PR-Solution-EU/FS20Uno/README.md

# FS20Uno
Arduino Uno controller for electric rooflight window and shutter using pushbuttons and FS20-SM8 receiver.

Detailed description under Wiki https://github.com/curzon01/FS20Uno/wiki.
