PR-Solution-EU/FS20Uno/Schaltplan/FS20SM8_DFF_MPC23017.pdf

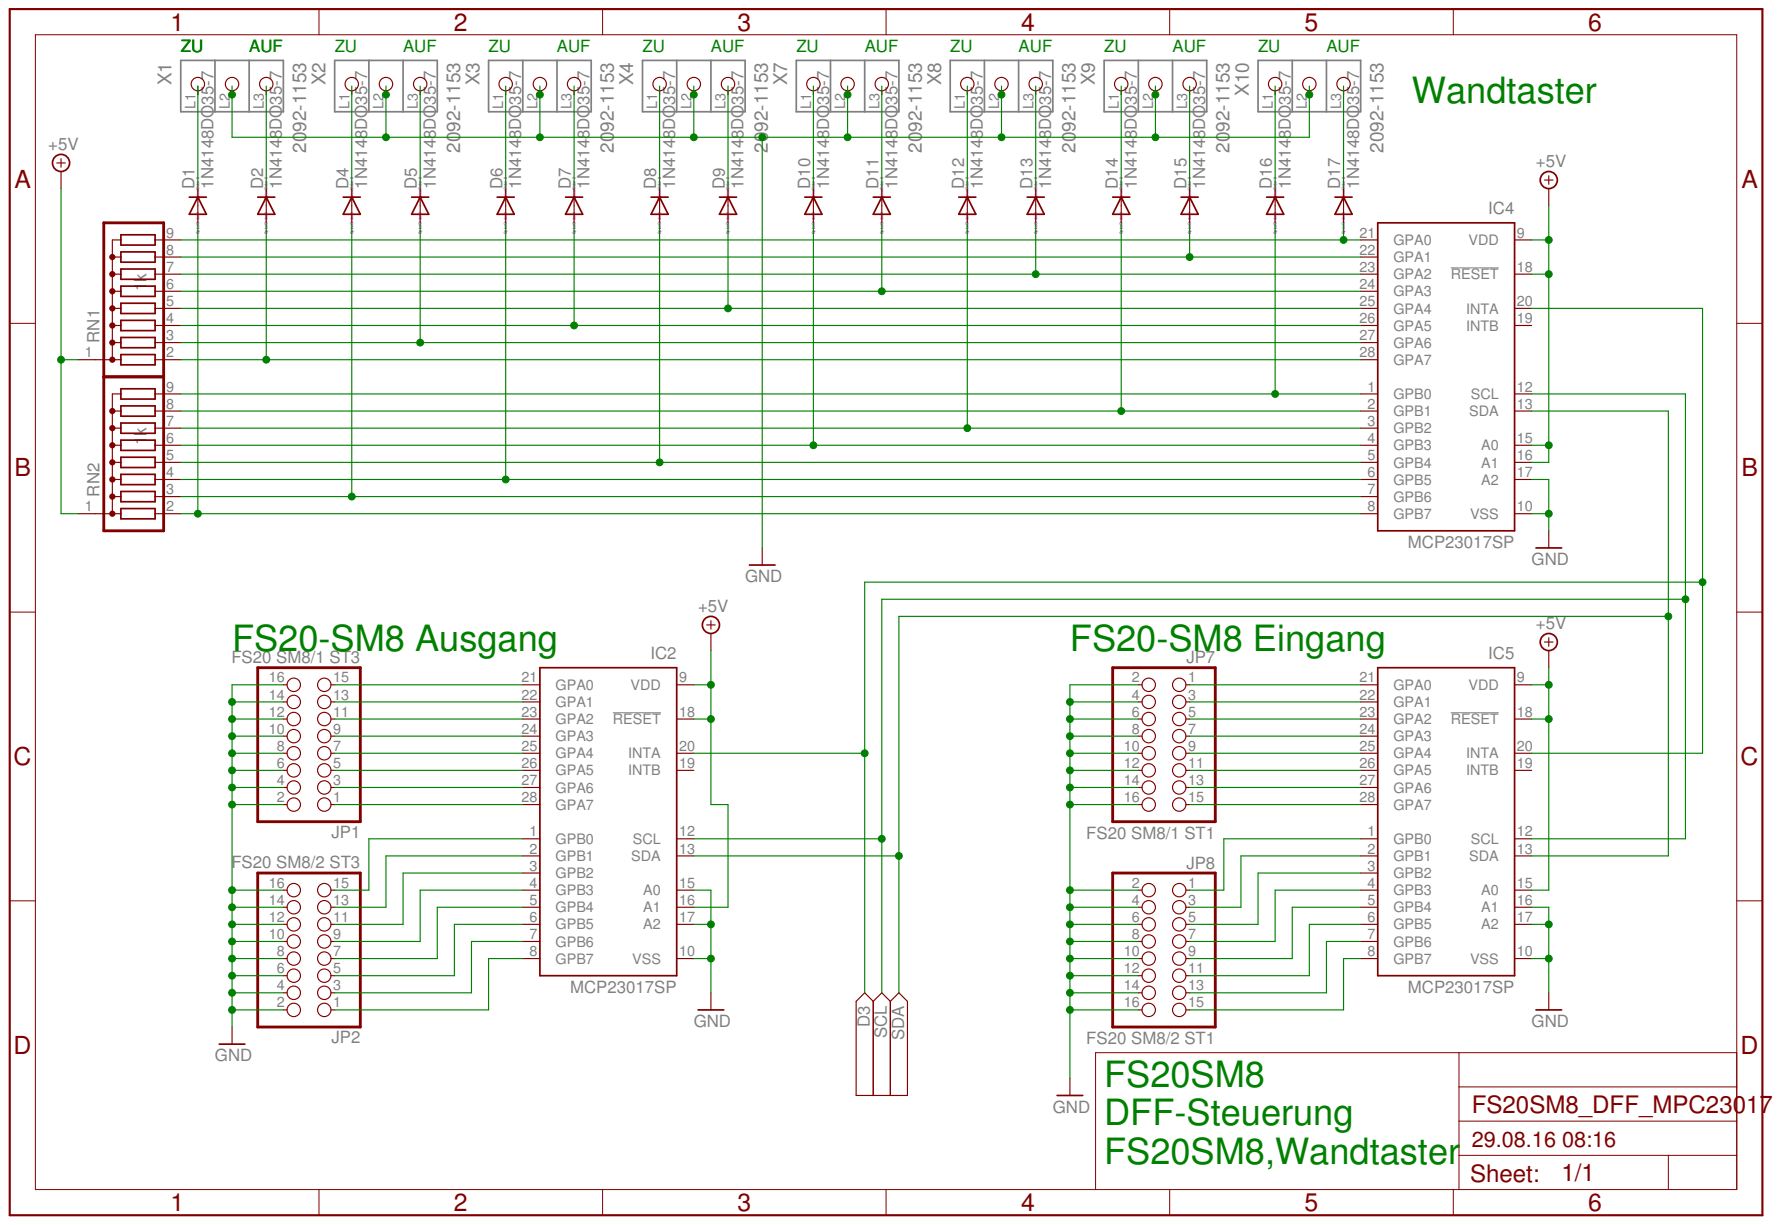
[picture p1: page 1]

FS20SM8 DFF-Steuerung FS20SM8,Wandtaster

Sheet: 1/1

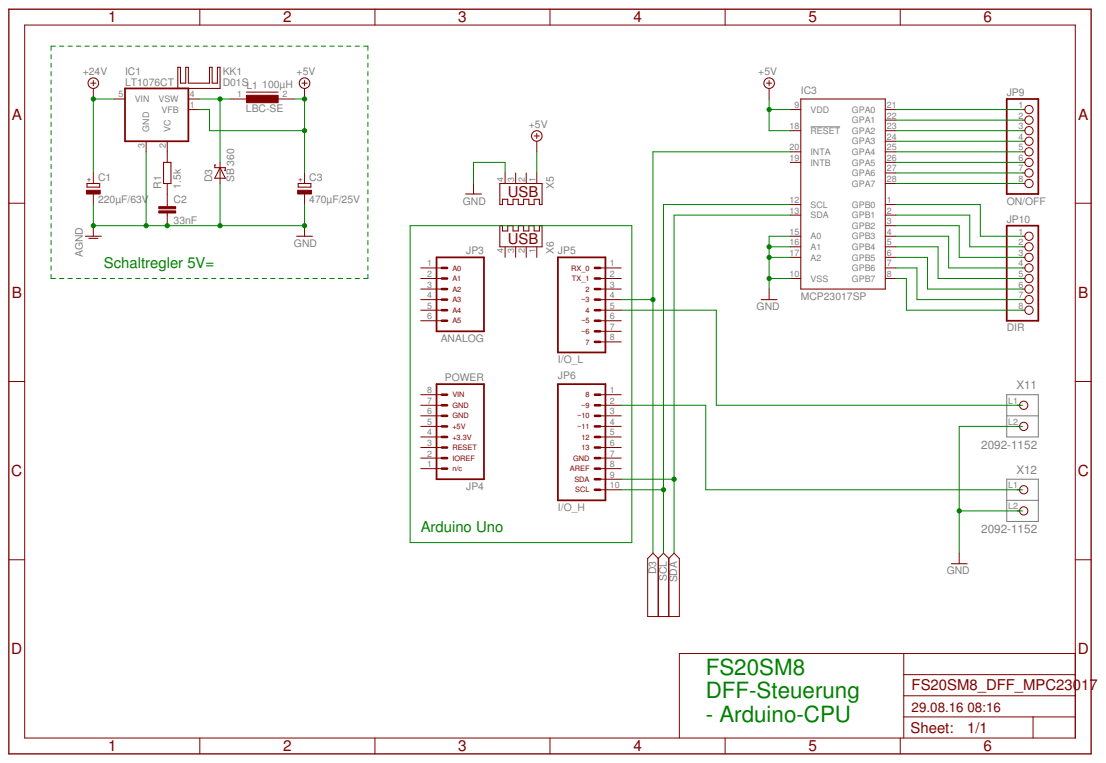
[picture p2: page 2]

FS20SM8 DFF-Steuerung - Arduino-CPU

Sheet: 1/1
