PR-Solution-EU/FS20Uno/Schaltplan/FS20SM8_DFF_Relais.pdf

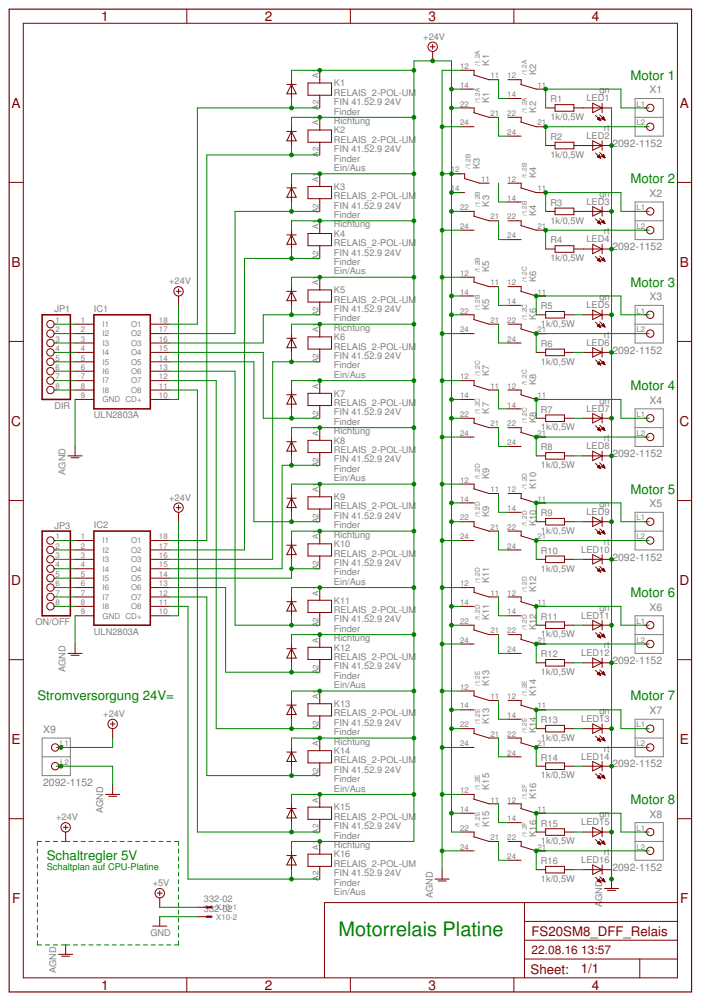
[picture p3: page 1]
