PR-Solution-EU/FS20Uno/Schaltplan/FS20SM8_DFF_MPC23017.sch

## EAGLE design Schaltplan/FS20SM8_DFF_MPC23017.sch (2016-08-29)

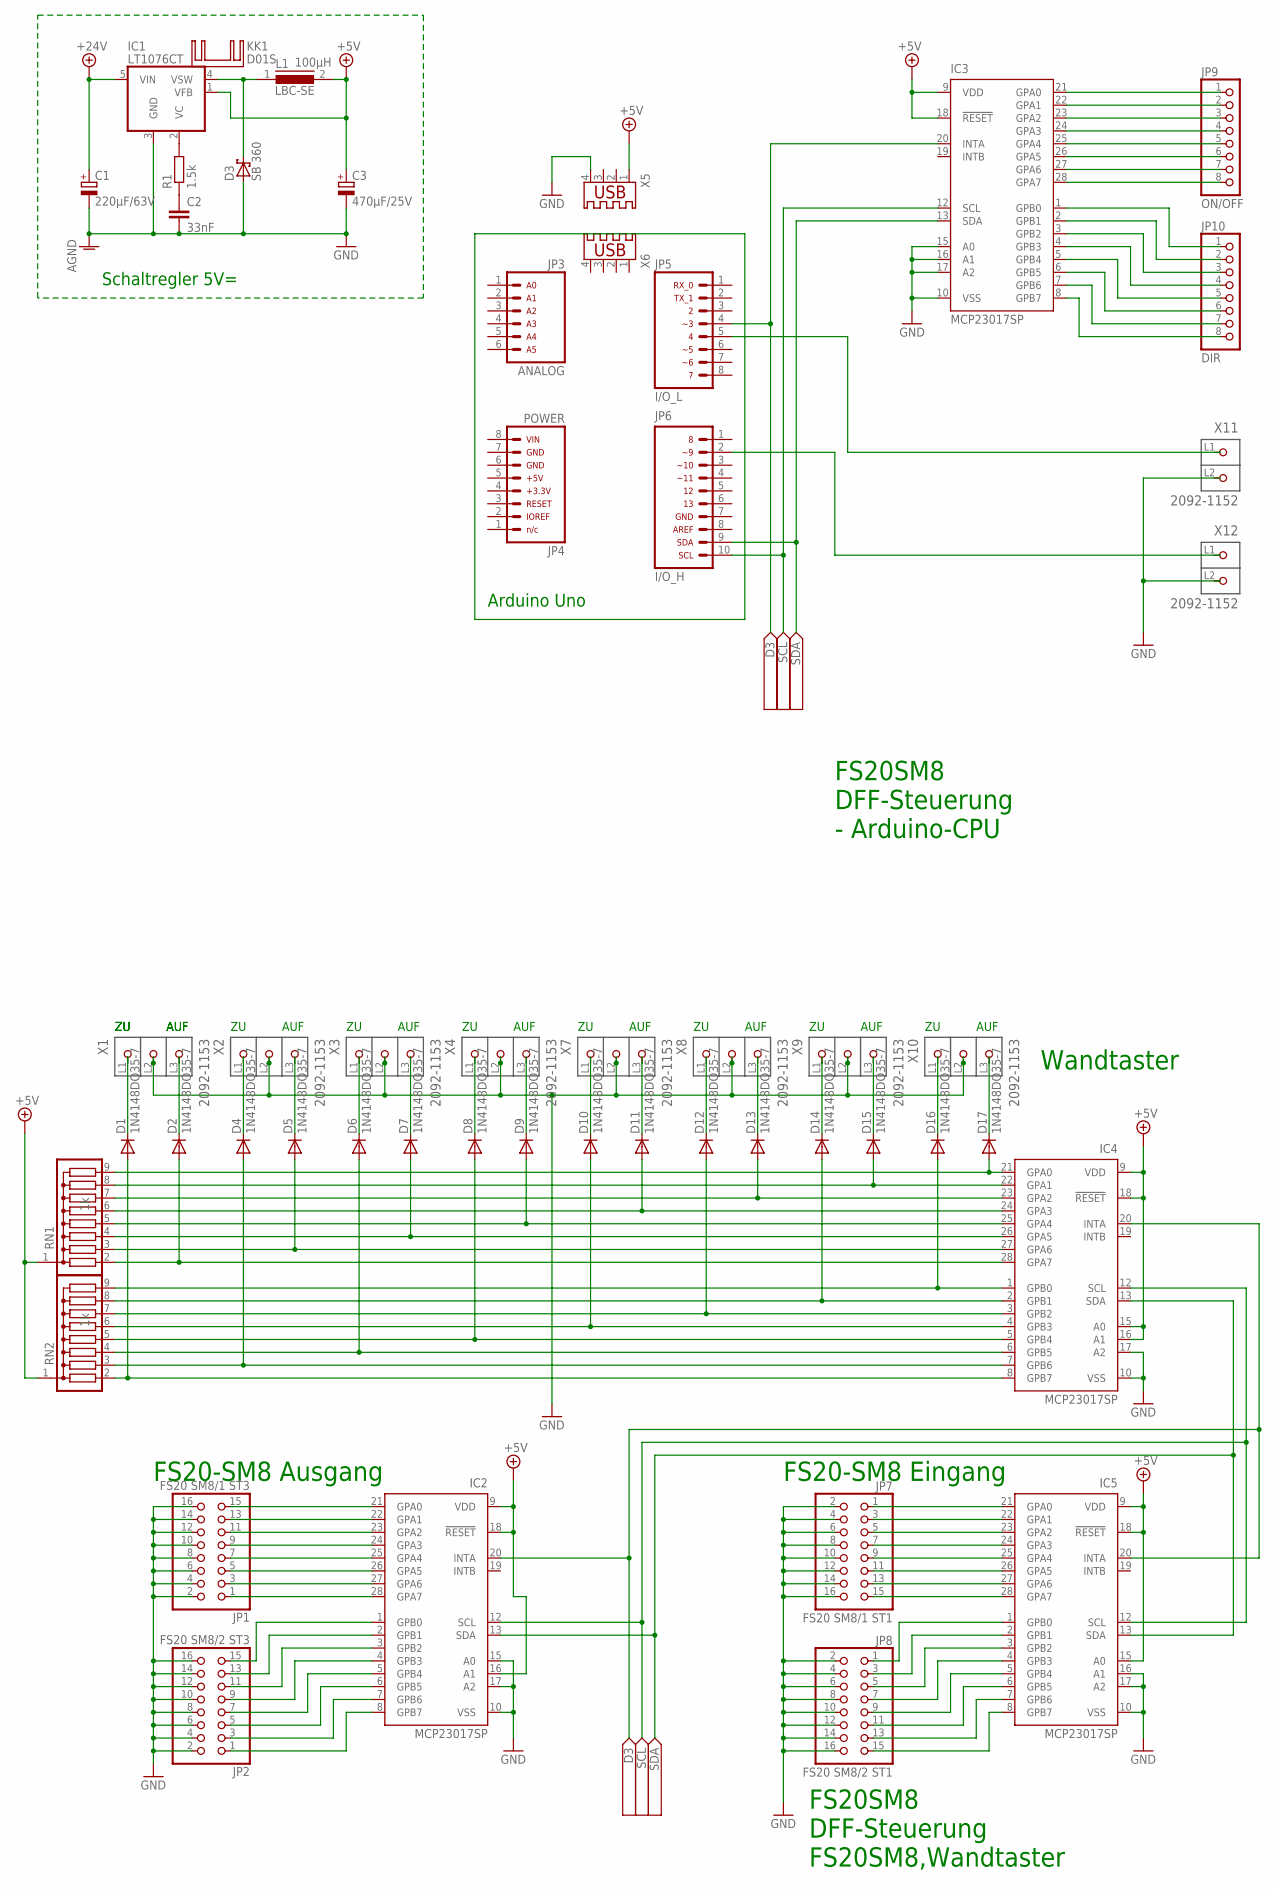
[picture p4: schematic FS20SM8_DFF_MPC23017.sch]

Parts:
C1: 220µF/63V; E5-10,5
C2: 33nF; C050-035X075
C3: 470µF/25V; E5-10,5
D1, D2, D4, D5, D6, D7, D8, D9, D10, D11, D12, D13, D14, D15, D16, D17: 1N4148DO35-7; DO35-7
D3: SB 360; DO201T15
IC1: LT1076CT; TO220-5
IC2, IC3, IC4, IC5: MCP23017SP; DIL28-3
JP1: FS20 SM8/1 ST3; 2X08
JP2: FS20 SM8/2 ST3; 2X08
JP3: ARDUINO_CONN-ANALOGSIP; CONN-1X06
JP4: ARDUINO_CONN-POWERSIP; CONN-1X08
JP5: ARDUINO_CONN-IO_LSIP; CONN-1X08
JP6: ARDUINO_CONN-IO_HSIP; CONN-1X10
JP7: FS20 SM8/1 ST1; 2X08
JP8: FS20 SM8/2 ST1; 2X08
JP9: ON/OFF; 1X08
JP10: DIR; 1X08
KK1: D01S
L1: LBC-SE
R1: 1.5k; 0204V
RN1, RN2: G08R; SIL9
X1, X2, X3, X4, X7, X8, X9, X10: 2092-1153; P-2092-1153
X5, X6: USB-A003
X11, X12: 2092-1152; P-2092-1152

Connections:
+5V: C3.+, IC1.1 (VFB), IC2.9 (VDD), IC2.16 (A1), IC2.18 (!RESET), IC3.9 (VDD), IC3.18 (!RESET), IC4.9 (VDD), IC4.15 (A0), IC4.16 (A1), IC4.18 (!RESET), IC5.9 (VDD), IC5.15 (A0), IC5.18 (!RESET), L1.2, RN1.1, RN2.1, X5.1
+24V: C1.+, IC1.5 (VIN)
AGND: C1.-, C2.2, C3.-, D3.A, IC1.3 (GND)
GND: IC2.10 (VSS), IC2.15 (A0), IC2.17 (A2), IC3.10 (VSS), IC3.15 (A0), IC3.16 (A1), IC3.17 (A2), IC4.10 (VSS), IC4.17 (A2), IC5.10 (VSS), IC5.16 (A1), IC5.17 (A2), JP1.2, JP1.4, JP1.6, JP1.8, JP1.10, JP1.12, JP1.14, JP1.16, JP2.2, JP2.4, JP2.6, JP2.8, JP2.10, JP2.12, JP2.14, JP2.16, JP7.2, JP7.4, JP7.6, JP7.8, JP7.10, JP7.12, JP7.14, JP7.16, JP8.2, JP8.4, JP8.6, JP8.8, JP8.10, JP8.12, JP8.14, JP8.16, X1.L2 (P2), X2.L2 (P2), X3.L2 (P2), X4.L2 (P2), X5.4, X7.L2 (P2), X8.L2 (P2), X9.L2 (P2), X10.L2 (P2)
unnamed: IC3.20 (INTA), JP5.4
unnamed: IC3.12 (SCL), JP6.10
unnamed: IC3.13 (SDA), JP6.9
unnamed: IC3.1 (GPB0), JP10.1
unnamed: IC3.2 (GPB1), JP10.2
unnamed: IC3.3 (GPB2), JP10.3
unnamed: IC3.4 (GPB3), JP10.4
unnamed: IC1.2 (VC), R1.2
unnamed: IC3.5 (GPB4), JP10.5
unnamed: IC3.6 (GPB5), JP10.6
unnamed: IC2.21 (GPA0), JP1.15
unnamed: IC3.7 (GPB6), JP10.7
unnamed: D1.C, X1.L1 (P1)
unnamed: D2.C, X1.L3 (P3)
unnamed: D5.C, X2.L3 (P3)
unnamed: D4.C, X2.L1 (P1)
unnamed: D7.C, X3.L3 (P3)
unnamed: D6.C, X3.L1 (P1)
unnamed: D8.C, X4.L1 (P1)
unnamed: IC3.21 (GPA0), JP9.1
unnamed: IC3.22 (GPA1), JP9.2
unnamed: IC3.23 (GPA2), JP9.3
unnamed: IC3.24 (GPA3), JP9.4
unnamed: D9.C, X4.L3 (P3)
unnamed: D10.C, X7.L1 (P1)
unnamed: D11.C, X7.L3 (P3)
unnamed: D12.C, X8.L1 (P1)
unnamed: IC3.25 (GPA4), JP9.5
unnamed: IC3.26 (GPA5), JP9.6
unnamed: IC3.27 (GPA6), JP9.7
unnamed: IC3.28 (GPA7), JP9.8
unnamed: D13.C, X8.L3 (P3)
unnamed: C2.1, R1.1
unnamed: D14.C, X9.L1 (P1)
unnamed: D15.C, X9.L3 (P3)
unnamed: D16.C, X10.L1 (P1)
unnamed: D17.C, X10.L3 (P3)
unnamed: IC3.8 (GPB7), JP10.8
unnamed: IC5.1 (GPB0), JP8.1
unnamed: IC5.2 (GPB1), JP8.3
unnamed: IC5.3 (GPB2), JP8.5
unnamed: IC2.22 (GPA1), JP1.13
unnamed: IC2.23 (GPA2), JP1.11
unnamed: D3.C, IC1.4 (VSW), L1.1
unnamed: IC2.24 (GPA3), JP1.9
unnamed: IC2.25 (GPA4), JP1.7
unnamed: IC2.26 (GPA5), JP1.5
unnamed: IC2.27 (GPA6), JP1.3
unnamed: IC2.28 (GPA7), JP1.1
unnamed: IC5.21 (GPA0), JP7.1
unnamed: IC5.22 (GPA1), JP7.3
unnamed: IC5.23 (GPA2), JP7.5
unnamed: IC5.24 (GPA3), JP7.7
unnamed: IC5.25 (GPA4), JP7.9
unnamed: IC5.26 (GPA5), JP7.11
unnamed: IC5.27 (GPA6), JP7.13
unnamed: IC5.28 (GPA7), JP7.15
unnamed: IC5.4 (GPB3), JP8.7
unnamed: IC5.5 (GPB4), JP8.9
unnamed: IC5.6 (GPB5), JP8.11
unnamed: IC5.7 (GPB6), JP8.13
unnamed: IC5.8 (GPB7), JP8.15
unnamed: IC2.12 (SCL), IC4.12 (SCL), IC5.12 (SCL)
unnamed: IC2.13 (SDA), IC4.13 (SDA), IC5.13 (SDA)
unnamed: IC2.20 (INTA), IC4.20 (INTA), IC5.20 (INTA)
unnamed: D17.A, IC4.21 (GPA0), RN1.9
unnamed: D16.A, IC4.1 (GPB0), RN2.9
unnamed: D14.A, IC4.2 (GPB1), RN2.8
unnamed: D13.A, IC4.23 (GPA2), RN1.7
unnamed: D12.A, IC4.3 (GPB2), RN2.7
unnamed: D11.A, IC4.24 (GPA3), RN1.6
unnamed: D10.A, IC4.4 (GPB3), RN2.6
unnamed: D15.A, IC4.22 (GPA1), RN1.8
unnamed: D9.A, IC4.25 (GPA4), RN1.5
unnamed: D8.A, IC4.5 (GPB4), RN2.5
unnamed: D7.A, IC4.26 (GPA5), RN1.4
unnamed: D6.A, IC4.6 (GPB5), RN2.4
unnamed: D5.A, IC4.27 (GPA6), RN1.3
unnamed: D4.A, IC4.7 (GPB6), RN2.3
unnamed: D2.A, IC4.28 (GPA7), RN1.2
unnamed: D1.A, IC4.8 (GPB7), RN2.2
unnamed: IC2.1 (GPB0), JP2.15
unnamed: IC2.2 (GPB1), JP2.13
unnamed: IC2.3 (GPB2), JP2.11
unnamed: IC2.4 (GPB3), JP2.9
unnamed: IC2.5 (GPB4), JP2.7
unnamed: IC2.6 (GPB5), JP2.5
unnamed: IC2.7 (GPB6), JP2.3
unnamed: IC2.8 (GPB7), JP2.1

Notes on the sheet:
FS20SM8 DFF-Steuerung - Arduino-CPU
FS20SM8 DFF-Steuerung FS20SM8,Wandtaster
AUF
Wandtaster
FS20-SM8 Ausgang
FS20-SM8 Eingang
Arduino Uno
Schaltregler 5V=
