PR-Solution-EU/FS20Uno/Schaltplan/FS20SM8_DFF_Relais.sch

## EAGLE design Schaltplan/FS20SM8_DFF_Relais.sch (2016-08-22)

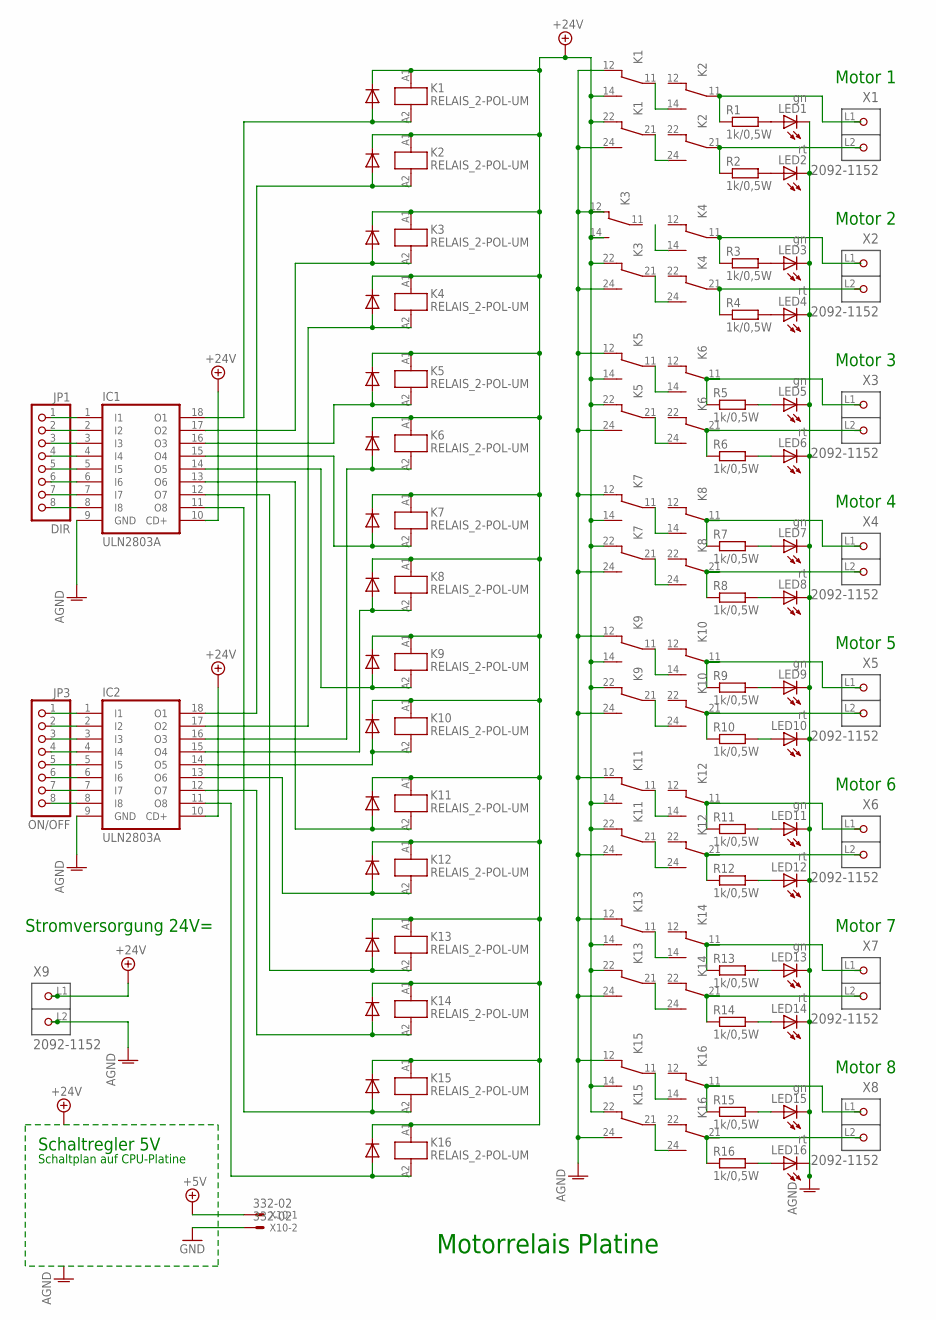
[picture p5: schematic FS20SM8_DFF_Relais.sch]

Parts:
IC1, IC2: ULN2803A; DIL18
JP1: DIR; 1X08
JP3: ON/OFF; 1X08
K1, K2, K3, K4, K5, K6, K7, K8, K9, K10, K11, K12, K13, K14, K15, K16: RELAIS_2-POL-UM
LED1, LED3, LED5, LED7, LED9, LED11, LED13, LED15: gn; LED3MM
LED2, LED4, LED6, LED8, LED10, LED12, LED14, LED16: rt; LED3MM
R1, R2, R3, R4, R5, R6, R7, R8, R9, R10, R11, R12, R13, R14, R15, R16: 1k/0,5W; 0207/2V
X1, X2, X3, X4, X5, X6, X7, X8, X9: 2092-1152; P-2092-1152
X10: 332-02

Connections:
+5V: X10.1
+24V: IC1.10 (CD+), IC2.10 (CD+), K1.14 (4), K1.22 (2), K1.A1, K2.A1, K3.12 (2), K3.14 (4), K3.22 (2), K3.A1, K4.A1, K5.14 (4), K5.22 (2), K5.A1, K6.A1, K7.14 (4), K7.22 (2), K7.A1, K8.A1, K9.14 (4), K9.22 (2), K9.A1, K10.A1, K11.14 (4), K11.22 (2), K11.A1, K12.A1, K13.14 (4), K13.22 (2), K13.A1, K14.A1, K15.14 (4), K15.22 (2), K15.A1, X9.L1 (P1)
AGND: IC1.9 (GND), IC2.9 (GND), K1.12 (2), K1.24 (4), K3.24 (4), K5.12 (2), K5.24 (4), K7.12 (2), K7.24 (4), K9.12 (2), K9.24 (4), K11.12 (2), K11.24 (4), K13.12 (2), K13.24 (4), K15.12 (2), K15.24 (4), LED1.K (C), LED2.K (C), LED3.K (C), LED4.K (C), LED5.K (C), LED6.K (C), LED7.K (C), LED8.K (C), LED9.K (C), LED10.K (C), LED11.K (C), LED12.K (C), LED13.K (C), LED14.K (C), LED15.K (C), LED16.K (C), X9.L2 (P2)
GND: X10.2
unnamed: K1.11 (1), K2.14 (4)
unnamed: IC2.18 (O1), K2.A2
unnamed: IC1.18 (O1), K1.A2
unnamed: K1.21 (1), K2.24 (4)
unnamed: IC1.17 (O2), K3.A2
unnamed: IC2.17 (O2), K4.A2
unnamed: IC1.16 (O3), K5.A2
unnamed: IC2.16 (O3), K6.A2
unnamed: IC1.15 (O4), K7.A2
unnamed: IC2.15 (O4), K8.A2
unnamed: K4.11 (1), R3.1
unnamed: K2.11 (1), R1.1
unnamed: K2.21 (1), R2.1
unnamed: K4.21 (1), R4.1
unnamed: K3.21 (1), K4.24 (4)
unnamed: K6.11 (1), R5.1
unnamed: K6.21 (1), R6.1
unnamed: K5.11 (1), K6.14 (4)
unnamed: K5.21 (1), K6.24 (4)
unnamed: K8.11 (1), R7.1
unnamed: K8.21 (1), R8.1
unnamed: K7.11 (1), K8.14 (4)
unnamed: K7.21 (1), K8.24 (4)
unnamed: IC1.14 (O5), K9.A2
unnamed: IC2.14 (O5), K10.A2
unnamed: IC1.13 (O6), K11.A2
unnamed: IC2.13 (O6), K12.A2
unnamed: IC1.12 (O7), K13.A2
unnamed: IC2.12 (O7), K14.A2
unnamed: IC1.11 (O8), K15.A2
unnamed: IC2.11 (O8), K16.A2
unnamed: K10.11 (1), R9.1
unnamed: K10.21 (1), R10.1
unnamed: K9.11 (1), K10.14 (4)
unnamed: K9.21 (1), K10.24 (4)
unnamed: K12.11 (1), R11.1
unnamed: K12.21 (1), R12.1
unnamed: K11.11 (1), K12.14 (4)
unnamed: K11.21 (1), K12.24 (4)
unnamed: K14.11 (1), R13.1
unnamed: K14.21 (1), R14.1
unnamed: K13.11 (1), K14.14 (4)
unnamed: K13.21 (1), K14.24 (4)
unnamed: K16.11 (1), R15.1
unnamed: K16.21 (1), R16.1
unnamed: K15.11 (1), K16.14 (4)
unnamed: K15.21 (1), K16.24 (4)
unnamed: LED1.A, R1.2
unnamed: LED2.A, R2.2
unnamed: LED3.A, R3.2
unnamed: LED4.A, R4.2
unnamed: LED5.A, R5.2
unnamed: LED6.A, R6.2
unnamed: LED7.A, R7.2
unnamed: LED8.A, R8.2
unnamed: LED9.A, R9.2
unnamed: LED10.A, R10.2
unnamed: LED11.A, R11.2
unnamed: LED12.A, R12.2
unnamed: LED13.A, R13.2
unnamed: LED14.A, R14.2
unnamed: LED15.A, R15.2
unnamed: LED16.A, R16.2
unnamed: IC1.1 (I1), JP1.1
unnamed: IC1.2 (I2), JP1.2
unnamed: IC1.3 (I3), JP1.3
unnamed: IC1.4 (I4), JP1.4
unnamed: IC1.5 (I5), JP1.5
unnamed: IC1.6 (I6), JP1.6
unnamed: IC1.7 (I7), JP1.7
unnamed: IC1.8 (I8), JP1.8
unnamed: IC2.1 (I1), JP3.1
unnamed: IC2.2 (I2), JP3.2
unnamed: IC2.3 (I3), JP3.3
unnamed: IC2.4 (I4), JP3.4
unnamed: IC2.5 (I5), JP3.5
unnamed: IC2.6 (I6), JP3.6
unnamed: IC2.7 (I7), JP3.7
unnamed: IC2.8 (I8), JP3.8

Notes on the sheet:
Motor 1
Motor 2
Motor 3
Motor 4
Motor 5
Motor 6
Motor 7
Motor 8
Motorrelais Platine
Stromversorgung 24V=
Schaltregler 5V
Schaltplan auf CPU-Platine
