PR-Solution-EU/FS20Uno/FS20Uno.h

#define MPC1    			0x0		// MCP23017 #1 I2C Address
#define MPC2    			0x1		// MCP23017 #2 I2C Address
#define MPC3				0x2		// MCP23017 #3 I2C Address
#define MPC4    			0x3		// MCP23017 #4 I2C Address
#define MPC_MOTORRELAIS		MPC1	// MPC for motor relais
#define MPC_SM8BUTTON		MPC2	// MPC for FS20-SM8 key outputs
#define MPC_SM8STATUS		MPC3	// MPC for FS20-SM8 output
#define MPC_PUSHBUTTON		MPC4	// MPC for push buttons
#define MPC_INT_INPUT 		3		// Arduino port for MPC IRQ
#define STATUS_LED 			LED_BUILTIN	// LED
#define RAIN_INPUT 			4		// Arduino port for rain sensor
#define RAIN_INPUT_ACTIVE	0		// Active level
#define RAIN_ENABLE			9		// Arduino Port for rain enable/disable input
#define RAIN_ENABLE_ACTIVE	1		// Active level
#define RANDOM_SEED_ANALOG_READ1	0
#define RANDOM_SEED_ANALOG_READ2	1
#define RANDOM_SEED_ANALOG_READ3	2
#define DEFAULT_MOTORTYPE			0b01010101	// WIN/JAL/WIN/JAL...
#define DEFAULT_SENDSTATUS			false
#define DEFAULT_ECHO				false
#define DEFAULT_TERM				'\r'
#define DEFAULT_LOGIN_TIMEOUT		60	// sec
#define DEFAULT_PASSWORD			PSTR("31415")
#define DEFAULT_RAINRESUMETIME		300	// sec
#define DEFAULT_LED_NORMAL			0x20080200	// bit pattern
#define DEFAULT_LED_RAIN			0xd7f5fd7f	// bit pattern
#define DEFAULT_LED_BITCOUNT		30	// #
#define DEFAULT_LED_BITLENGTH		100	// ms
#define MAX_LEDPATTERN_BITS			32
#define SERIAL_BAUDRATE				115200
#define TIMER_MS					10
#define WATCHDOG_TIME				4000
#define WATCHDOG_REBOOT_DELAY		250
#define ALIVE_TIMER					500
#define RAIN_DEBOUNCE_TIME			20	// ms
#define WPB_DEBOUNCE_TIME			80	// ms
#define SM8_DEBOUNCE_TIME			20	// ms
#define MAX_MOTORS					8
#define RELAIS_OPERATE_TIME			20	// ms
#define MOTOR_SWITCHOVER			250	// ms
#define MOTOR_MINRUNTIME		 	500	// 0.5 seconds
#define MOTOR_MAXRUNTIME		 	600000	// 10 minutes
#define MOTOR_WINDOW_MAXRUNTIME		60000	// 60 seconds
#define MOTOR_JALOUSIE_MAXRUNTIME	20000	// 2 seconds
#define MOTOR_WINDOW_OVERTRAVELTIME		2000	// 2 seconds
#define MOTOR_JALOUSIE_OVERTRAVELTIME	1000	// 1 second
#define FS20_SM8_IN_RESPONSE		150	// ms
#define FS20_SM8_IN_PROGRAMMODE		6000	// 6 seconds
#define MAX_NAMELEN					21
#define MOTOR_OPEN			1
#define MOTOR_OPEN_DELAYED	(MOTOR_SWITCHOVER/TIMER_MS)
#define MOTOR_CLOSE			-1
#define MOTOR_CLOSE_DELAYED	(-MOTOR_SWITCHOVER/TIMER_MS)
#define MOTOR_OFF			0
#define NO_POSITION 			MAX_MOTOR_TIMER
#define NO_RESUME_POSITION		UINT8_MAX
#define NO_RESUME_DELAY 		MAX_MOTOR_TIMER
typedef unsigned int  	WORD;
typedef unsigned long 	DWORD;
typedef unsigned long	TIMER;
typedef uint32_t		LEDPATTERN;
#if MAX_MOTORS<=4
	#define IOBITS_ZERO		0x00
	#define IOBITS_MASK		0xFF
	#define IOBITS_LOWMASK	0x0F
	#define IOBITS_HIGHMASK	0xF0
	typedef byte MOTORBITS;
	typedef byte IOBITS;
#elif MAX_MOTORS<=8
	#define IOBITS_ZERO		0x0000
	#define IOBITS_MASK		0xFFFF
	#define IOBITS_LOWMASK	0x00FF
	#define IOBITS_HIGHMASK	0xFF00
	typedef byte MOTORBITS;
	typedef unsigned int IOBITS;
#elif MAX_MOTORS<=16
	#define IOBITS_ZERO		0x00000000
	#define IOBITS_MASK		0xFFFFFFFF
	#define IOBITS_LOWMASK	0x0000FFFF
	#define IOBITS_HIGHMASK	0xFFFF0000
	typedef unsigned int MOTORBITS;
	typedef unsigned long IOBITS;
#else
	#assert Too many motor devices (MAX_MOTORS > 16)
#endif
#define IOBITS_CNT	(2*MAX_MOTORS)
typedef char MOTOR_CTRL;
#if   (MOTOR_MAXRUNTIME/TIMER_MS)<=UINT8_MAX
	#define MAX_MOTOR_TIMER UINT8_MAX
	typedef byte MOTOR_TIMER;
#elif (MOTOR_MAXRUNTIME/TIMER_MS)<=UINT16_MAX
	#define MAX_MOTOR_TIMER UINT16_MAX
	typedef WORD MOTOR_TIMER;
#else
	#define MAX_MOTOR_TIMER UINT32_MAX;
	typedef DWORD MOTOR_TIMER;
#endif
#if   (FS20_SM8_IN_RESPONSE/TIMER_MS)<=UINT8_MAX
	typedef byte SM8_TIMEOUT;
#elif (FS20_SM8_IN_RESPONSE/TIMER_MS)<=UINT16_MAX
	typedef WORD SM8_TIMEOUT;
#else
	typedef DWORD SM8_TIMEOUT;
#endif
#define EEPROM_WEARLEVELING_WRITECNT	1000
struct MYEEPROMHEADER {
	uint64_t Magic;
	uint32_t WriteCount;
};
struct MYEEPROM {
	DWORD		CRC32;
	byte		DataVersion;
	LEDPATTERN 	LEDPatternNormal;
	LEDPATTERN 	LEDPatternRain;
	byte 		LEDBitCount;
	WORD 		LEDBitLenght;
	MOTORBITS	MTypeBitmask;
	volatile DWORD MaxRuntime[MAX_MOTORS];
	volatile DWORD OvertravelTime[MAX_MOTORS];
	char 		MotorName[MAX_MOTORS][MAX_NAMELEN];
	volatile MOTOR_TIMER MotorPosition[MAX_MOTORS];
	#define RAIN_BIT_AUTO	(1<<0)
	#define RAIN_BIT_ENABLE	(1<<1)
	#define RAIN_BIT_RESUME	(1<<2)
	byte 		Rain;
	WORD 		RainResumeTime;
	bool 		Echo;
	char 		Term;
	bool 		SendStatus;
	DWORD		OperatingHours;
	WORD		LoginTimeout;
	DWORD		EncryptKey[4];
	char		Password[17];
};
enum MTYPE {JALOUSIE = 0, WINDOW};
enum STATUSTYPE {SYSTEM, MOTOR, FS20OUT, FS20IN, PUSHBUTTON, RAIN};
enum CRYPT_MODE{ ENCRYPT, DECRYPT };
enum PRINTCMDTYPE {PRINT_CMD = 0,PRINT_PARM,PRINT_DESC,PRINT_PDESC,PRINT_PROTECT};
#define STRINGIFY(x) #x
#define TOSTRING(x) STRINGIFY(x)
extern unsigned long timer0_millis;
