PR-Solution-EU/FS20Uno/I2C.ino

/* ===================================================================
 * Function:	expanderWriteWord
 * Return:
 * Arguments:   address - expander hardware address
 *              reg     - expander register address
 *              data    - word to write
 * Description: write a word to the expander
 * ===================================================================*/
void expanderWriteWord(const byte address, const byte reg, const unsigned int data )
{
	Wire.beginTransmission((const byte)(0x20|address));
	Wire.write(reg);
	Wire.write( lowByte(data) ); 	// port A
	Wire.write( highByte(data) ); 	// port B
	Wire.endTransmission();
}

/* ===================================================================
 * Function:	expanderWriteBoth
 * Return:
 * Arguments:   address - expander hardware address
 *              reg     - expander register address
 *              data    - byte to write
 * Description: write the same byte to both (A & B) reg of the expander
 * ===================================================================*/
void expanderWriteBoth(const byte address, const byte reg, const byte data )
{
	Wire.beginTransmission((const byte)(0x20|address));
	Wire.write(reg);
	Wire.write(data);  // port A
	Wire.write(data);  // port B
	Wire.endTransmission();
}

/* ===================================================================
 * Function:	expanderWrite
 * Return:
 * Arguments:   address - expander hardware address
 *              reg     - expander register address
 *              data    - byte to write
 * Description: write a byte to the expander
 * ===================================================================*/
void expanderWrite(const byte address, const byte reg, const byte data )
{
	Wire.beginTransmission ((const byte)(0x20|address));
	Wire.write(reg);
	Wire.write(data);  // port A
	Wire.endTransmission();
}

/* ===================================================================
 * Function:	expanderRead
 * Return:		the byte read
 * Arguments:   address - expander hardware address
 *              reg     - expander register address
 * Description: read a byte from the expander
 * ===================================================================*/
byte expanderRead(const byte address, const byte reg)
{
	Wire.beginTransmission((const byte)(0x20|address));
	Wire.write(reg);
	Wire.endTransmission();
	Wire.requestFrom((const byte)(0x20|address), (byte)1);
	return Wire.read();
}

/* ===================================================================
 * Function:	expanderReadWord
 * Return:		the word read
 * Arguments:   address - expander hardware address
 *              reg     - expander register address
 * Description: read a word from the expander
 * ===================================================================*/
unsigned int expanderReadWord(const byte address, const byte reg)
{
	return expanderRead(address, reg) | (expanderRead(address, reg+1)<<8);
}
