PR-Solution-EU/FS20Uno/(commit log)

2016-07-29 Initial commit - working button inputs with debouncing
2016-08-01 Motor output working (incl. motor timeout)
2016-08-01 MOTOR_SWITCHOVER fixed
2016-08-01 FS20 switch control on motor direction changes or motor switched off
2016-08-01 Rain sensor inputs added (w/o debouncing)
2016-08-01 Rain sensor working
2016-08-02 Rain sensor fixed Motor type cmd fixed Cmd interface commands clean-up Constant string clean-up
    [EEPROM.ino, FS20Uno.ino, SerialCmd.ino]
2016-08-03 Cmd LED added, LED blink fixed
    [FS20Uno.h, FS20Uno.ino, SerialCmd.ino]
2016-08-03 Rain sensor commands, several bugfixes
    [EEPROM.ino, FS20Uno.h, FS20Uno.ino, SerialCmd.ino]
2016-08-03 Cmd RAINSTATUS bugfix (still one TODO)
    [FS20Uno.ino]
2016-08-04 Cmd 'motor' bugfix (same cmd toggled) ctrlMotorRelais bugfix (switch different motors switched also other motors)
    [FS20Uno.ino, SerialCmd.ino]
2016-08-04 Command Interface bugfix ('LED' not working, 'STATUS' not stored) SM8 control bugfix
    [FS20Uno.ino, SerialCmd.ino]
2016-08-04 motor direction change using SM8 ctrl fixed I2C code clean-up (constant usage)
    [FS20Uno.ino, I2C.h]
2016-08-04 Rain bugfix RAINSENSOR bugfix
    [FS20Uno.ino, SerialCmd.ino]
2016-08-05 Motor relais operation time for all status changes bugfix SM8 ctrl bugfix (when switched from open-close-open)
    [FS20Uno.h, FS20Uno.ino, SerialCmd.ino]
2016-08-05 Cmd interface output fixed
    [FS20Uno.h, FS20Uno.ino, SerialCmd.ino]
2016-08-07 Cmd 'FS20' added (incl. FS20 programming mode) Cmd 'FACTORYRESET' added SerialCommand bugfix Setup MPC bugfix ISR MPC bugfix
    [FS20Uno.h, FS20Uno.ino, SerialCmd.ino]
2016-08-12 millis() overflow bugfix Changes of any eeprom* var now written to EEPROM Rain sensor logic changed
    [EEPROM.ino, FS20Lib.ino, FS20Uno.h, FS20Uno.ino, SerialCmd.ino]
2016-08-15 Cmd FS20 PRG bugfix Default motor types changed
    [FS20Lib.ino, FS20Uno.h, FS20Uno.ino, SerialCmd.ino]
2016-08-16 Cmd MOTOR paramater TOGGLE added
2016-08-17 Cmd MOTOR parameter TOPEN and TCLOSE added
2016-08-17 Cmd MOTOR changed TOPEN, TCLOSE behavior
2016-08-18 Cmd interface now returns OK and ERROR at all
    [FS20Uno.h, FS20Uno.ino, SerialCmd.ino]
2016-08-19 Cmd MOTOR enhanced (more STATUS, SYNC added) Cmd MOTOR current opening state displays BETWEEN Cmd interface clean-up
2016-08-20 Cmd MOTORNAME added Motor timeout auto-learn added (hold PB > 10s to learn new timeout) SerialCmd source clean-up EEPROM variable and EEPROM access clean-up Getting PB values from MPC bugfix
    [EEPROM.ino, FS20Lib.ino, FS20Uno.h, FS20Uno.ino, SerialCmd.ino, SerialCommand.h]
2016-08-21 Cmd MOTOR GOTO added Cmd RAIN RESUME/FORGET added Src clean-up and reduced size (recoded EEPROM routines)
2016-08-22 Circuit diagrams added
    [FS20SM8_DFF_MPC23017.sch, FS20SM8_DFF_Relais.sch]
2016-08-24 Uptime now with overflow handling (more than 130 years) Operation hours stored in EEPROM Cmd UPTIME now with operation hours
    Der Sketch verwendet 30.352 Bytes (94%) des Programmspeicherplatzes. Das Maximum sind 32.256 Bytes.
    Globale Variablen verwenden 1.532 Bytes (74%) des dynamischen Speichers, 516 Bytes für lokale Variablen verbleiben. Das Maximum sind 2.048 Bytes.
2016-08-29 Code optimized Circuit small changes
    Der Sketch verwendet 29.826 Bytes (92%) des Programmspeicherplatzes. Das Maximum sind 32.256 Bytes.
    Globale Variablen verwenden 1.342 Bytes (65%) des dynamischen Speichers, 706 Bytes für lokale Variablen verbleiben. Das Maximum sind 2.048 Bytes.
    [FS20SM8_DFF_MPC23017.sch]
2016-09-04 Clear resumeMotorPosition on RAIN FORGET command Used NO_RESUME_DELAY for resumeDelay when not set
    Der Sketch verwendet 29.856 Bytes (92%) des Programmspeicherplatzes. Das Maximum sind 32.256 Bytes.
    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
2016-09-08 Enhanced status messages Cmd MOTOR goto also possible without goto
    Der Sketch verwendet 30.286 Bytes (93%) des Programmspeicherplatzes. Das Maximum sind 32.256 Bytes.
    Globale Variablen verwenden 1.346 Bytes (65%) des dynamischen Speichers, 702 Bytes für lokale Variablen verbleiben. Das Maximum sind 2.048 Bytes.
2016-09-10 Code size optimized Help text size optimized
    Der Sketch verwendet 26.880 Bytes (83%) des Programmspeicherplatzes. Das Maximum sind 32.256 Bytes.
    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
2016-09-11 Cmd BACKUP/RESTORE added Compile long/short HELP to save program space (#define CMDHELP_LONG)
    Der Sketch verwendet 31.040 Bytes (96%) des Programmspeicherplatzes. Das Maximum sind 32.256 Bytes.
    Globale Variablen verwenden 1.385 Bytes (67%) des dynamischen Speichers, 663 Bytes für lokale Variablen verbleiben. Das Maximum sind 2.048 Bytes.
    [EEPROM.ino, FS20Lib.ino, FS20Uno.h, FS20Uno.ino, SerialCmd.ino, SerialCommand.cpp, SerialCommand.h]
2016-09-11 sendStatus Motor not sent when set by interrupt routine
    Der Sketch verwendet 31.014 Bytes (96%) des Programmspeicherplatzes. Das Maximum sind 32.256 Bytes.
    Globale Variablen verwenden 1.386 Bytes (67%) des dynamischen Speichers, 662 Bytes für lokale Variablen verbleiben. Das Maximum sind 2.048 Bytes.
2016-09-11 Status msg SYS changed to SYSTEM Default motor names now "Window" or "Jalousie"
    Der Sketch verwendet 31.084 Bytes (96%) des Programmspeicherplatzes. Das Maximum sind 32.256 Bytes.
    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
2016-09-11 Bugfix: sendStatus not properly working
    Der Sketch verwendet 31.142 Bytes (96%) des Programmspeicherplatzes. Das Maximum sind 32.256 Bytes.
    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
    [FS20Lib.ino, FS20Uno.ino, SerialCmd.ino]
2016-09-11 Cmd RESET added
    Der Sketch verwendet 31.346 Bytes (97%) des Programmspeicherplatzes. Das Maximum sind 32.256 Bytes.
    Globale Variablen verwenden 1.401 Bytes (68%) des dynamischen Speichers, 647 Bytes für lokale Variablen verbleiben. Das Maximum sind 2.048 Bytes.
    [FS20Uno.ino, SerialCmd.ino, SerialCommand.h]
2016-09-11 Cmd RESET changed to long delay before restart
    Der Sketch verwendet 31.380 Bytes (97%) des Programmspeicherplatzes. Das Maximum sind 32.256 Bytes.
    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
    [SerialCmd.ino]
2016-09-11 Give info on startup when defaults set
    Der Sketch verwendet 31.430 Bytes (97%) des Programmspeicherplatzes. Das Maximum sind 32.256 Bytes.
    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
2016-09-11 Motor overtravel time added
    Der Sketch verwendet 31.782 Bytes (98%) des Programmspeicherplatzes. Das Maximum sind 32.256 Bytes.
    Globale Variablen verwenden 1.433 Bytes (69%) des dynamischen Speichers, 615 Bytes für lokale Variablen verbleiben. Das Maximum sind 2.048 Bytes.
2016-09-11 Cmd BACKUP enhanced to set values via cmd interface Cmd MOTOR SYNC fixed (now closes all motors to sync)
    Der Sketch verwendet 29.790 Bytes (92%) des Programmspeicherplatzes. Das Maximum sind 32.256 Bytes.
    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
    [FS20Lib.ino, FS20Uno.h, FS20Uno.ino, SerialCmd.ino]
2016-09-12 Cmd MOTOR GOTO bugfix Cmd MOTOR GOTO <p>: p=0 same as CLOSE, p=100 is same as OPEN Cmd BACKUP RAIN settings added Cmd RAIN add WET|DRY RAIN common status output
    Der Sketch verwendet 29.788 Bytes (92%) des Programmspeicherplatzes. Das Maximum sind 32.256 Bytes.
    Globale Variablen verwenden 1.421 Bytes (69%) des dynamischen Speichers, 627 Bytes für lokale Variablen verbleiben. Das Maximum sind 2.048 Bytes.
    [EEPROM.ino, FS20Lib.ino, FS20Uno.ino, SerialCmd.ino]
2016-09-12 sendStatus for MOTOR bugfix
    Der Sketch verwendet 29.808 Bytes (92%) des Programmspeicherplatzes. Das Maximum sind 32.256 Bytes.
    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
    [FS20Lib.ino, FS20Uno.ino, SerialCmd.ino]
2016-09-13 Circuit PDF updated
2016-09-13 Update README.md Remove Eagle circuit backup
2016-09-13 Program size optimized
    Der Sketch verwendet 29.720 Bytes (92%) des Programmspeicherplatzes. Das Maximum sind 32.256 Bytes.
    Globale Variablen verwenden 1.413 Bytes (68%) des dynamischen Speichers, 635 Bytes für lokale Variablen verbleiben. Das Maximum sind 2.048 Bytes.
2016-09-14 Online help code optimized to get full help with all functions
    Der Sketch verwendet 31.792 Bytes (98%) des Programmspeicherplatzes. Das Maximum sind 32.256 Bytes.
    Globale Variablen verwenden 1.347 Bytes (65%) des dynamischen Speichers, 701 Bytes für lokale Variablen verbleiben. Das Maximum sind 2.048 Bytes.
2016-09-15 Cmd LED blink pattern added
    Sketch uses 30,476 bytes (94%) of program storage space. Maximum is 32,256 bytes.
    Global variables use 1,322 bytes (64%) of dynamic memory, leaving 726 bytes for local variables. Maximum is 2,048 bytes.
2016-09-16 Cmd RAIN ON bugfix RAIN status message changed Status msg for rain now: 5 RAIN rainstatus [*input:*setting] enablestatus [*input:*setting] mode resumemode (delay) - values in square bracket displays 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
    Sketch uses 30,772 bytes (95%) of program storage space. Maximum is 32,256 bytes.
    Global variables use 1,330 bytes (64%) of dynamic memory, leaving 718 bytes for local variables. Maximum is 2,048 bytes.
    [FS20Uno.ino, SerialCmd.ino, SerialCommand.cpp, SerialCommand.h]
2016-09-16 Cmd RAIN ON bugfix RAIN status message changed Status msg for rain now: 5 RAIN rainstatus [*input:*setting] enablestatus [*input:*setting] mode resumemode (delay) - values in square bracket displays 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
    Global variables use 1,330 bytes (64%) of dynamic memory, leaving 718 bytes for local variables. Maximum is 2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
    [FS20Uno.ino, SerialCmd.ino, SerialCommand.cpp, SerialCommand.h]
2016-09-17 Cmd LOGIN timeout bugfix LOGIN status output added Protected all commands with LOGIN Restrict help output to unprotected commands when not logged in Cmd HELP ALL format fix
    Sketch uses 32,246 bytes (99%) of program storage space. Maximum is 32,256 bytes.
    Global variables use 1,414 bytes (69%) of dynamic memory, leaving 634 bytes for local variables. Maximum is 2,048 bytes.
    [FS20Uno.h, FS20Uno.ino, SerialCmd.ino]
2016-09-17 Cmd BACKUP fix MOTORTYPE times MOTOR TIME status output fix
    Sketch uses 31,934 bytes (99%) of program storage space. Maximum is 32,256 bytes.
    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
    [SerialCmd.ino]
2016-09-19 Code clean-up EEPROM code rewritten, simple wear-leveling added Setting overtravel time defaults on init MOTORTIME check against minimum value added PASSWD parameter not optional anymore (needed to s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
    Sketch uses 32,118 bytes (99%) of program storage space. Maximum is 32,256 bytes.
    Global variables use 1,465 bytes (71%) of dynamic memory, leaving 583 bytes for local variables. Maximum is 2,048 bytes.
2016-10-06 Cmd INFO: Wear leveling percent status added Cmd UPTIME bugfix: LED not blinking when update times
    Sketch uses 32,256 bytes (100%) of program storage space. Maximum is 32,256 bytes.
    Global variables use 1,479 bytes (72%) of dynamic memory, leaving 569 bytes for local variables. Maximum is 2,048 bytes.
    [FS20Uno.ino, SerialCmd.ino]
2017-07-23 add lockStoreResumePosition to prevent rain window stored position is deleted when rain detection is flapping during rain resume time
    Sketch uses 32,170 bytes (99%) of program storage space. Maximum is 32,256 bytes.
    Global variables use 1,480 bytes (72%) of dynamic memory, leaving 568 bytes for local variables. Maximum is 2,048 bytes.
    [FS20Uno.h, FS20Uno.ino, SerialCmd.ino]
