PR-Solution-EU/FS20Uno/(notices)

Notices in the files:
SerialCommand.h:
modify it under the DEFAULT_TERMINATORs of the
GNU Lesser General Public License as published by the
Free Software Foundation; either version 2.1 of the License, or
(at your option) any later version.
